mangiacotti/N1/N1 rev0.ods

Sheet: ToC
ID Range | Title | Status | Name | Date
100 | Terms and Acronyms | released | mangiacotti | 13-Jun-2016
200 | Use Cases | released | mangiacotti | 13-Jun-2016
300 | Requirements | released | mangiacotti | 13-Jun-2016
400 | Specifications | released | mangiacotti | 13-Jun-2016
500 | Functions | released | mangiacotti | 13-Jun-2016
600 | Spec Tests | completed | mangiacotti | 14-Jun-2016
700 | System Tests | completed | mangiacotti | 13-Jun-2016
800 | Exception Tests | completed | mangiacotti | 13-Jun-2016
900 | BOM | released | mangiacotti | 26-May-2016
1000 | Schematics | released | mangiacotti | 14-Jun-2016
1100 | Defects | mediums and highs closed | mangiacotti | 4-Jun-2016
1200 | Signature Manifest | released | mangiacotti | 12-Jun-2016
n/a | User Manual | not started
n/a | Rev History | pending tests for release | mangiacotti | 13-Jun-2016

Sheet: Terms and Acronyms
100
ID | Term or Acronym | Description
101 | SBC | Single Board Computer
102 | LED | Light Emitting Diode
103 | NVM | Non-Volative Memory
104 | checksum | MD-5 hashing algorithm of the code for comparisions
105 | LTQ | Long Term Qualification. Post release
106 | STQ | Short Term Qualification. Prior to release
107 | PCB | Printed Circuit Board

Sheet: Defects
1100
ID | Defect Description | Criticality | Resolution | Status | Version Fixed In | Name | Date Closed
1101 | LEDs cycle when setting is required but how to handle when red has been set but not yellow | medium | new requirements to separate blinking instead of cycling | closed | 1.0 | mangiacotti | 31-May-2016
1102 | Create a 'processMessage' function so that messages can be suppressed when not in verbose mode | medium | canceled. Better performance as-is and still readable | closed | 1.0 | mangiacotti | 31-May-2016
1103 | How annunciate to user of invalid distance setting | high | Keep blinking light until set correctly | closed | 1.0 | mangiacotti | 31-May-2016
1104 | More code comments | high | done | closed | 1.0 | mangiacotti | 02-Jun-2016
1105 | With a human body in front of ultra-sonic sensor, there are some spurious readings of objects being far away. Experiment with function 'sonar.ping_median' | medium | ping_median is very slow scanning. Makes push buttons inconsistent. Plan to test with automobiles. | closed |  | mangiacotti | 09-Jun-2016
1106 | Push buttons not consistent because they are pushed for more than one scan | high | program a button_unclick event | closed | 1.0 | mangiacotti | 12-Jun-2016
1107 | Save settings to EEPROM | high | EEPROM.get() and EEPROM.put() included value validation | closed | 1.0 | mangiacotti | 12-Jun-2016
1108 | Power-up product information report to serial port | high | added function. Included control code 501 support. Included checksum of source code | closed | 1.0 | mangiacotti | 12-Jun-2016
1109 | Proper name | low | Parky McParkFace? | open |  | mangiacotti
1110 | Lenses for amplifying small LED to be visible from far away | low |  | open
1111 | Proper box to place components into | low |  | open
1112 | If red distance is set to less than yellow distance then yellow distance is essentially disabled | low |  | open

Sheet: Use Cases
200
ID | Description | Notes
201 | Set yellow light distance
202 | Set red light distance
203 | Clear all settings
204 | Yellow light on 30 seconds when within yellow range
205 | Red light on 30 seconds when within red range
206 | Green light on for 30 seconds when not within yellow or red range
207 | Power-on light sequence to inform user that distance setting is required
208 | Save all settings to NVM

Sheet: Requirements
300
ID | Description | Notes
301 | User shall be able to press a momentary push-button to set the distance to energize the yellow light
302 | System shall report status to user of success/failure of setting yellow light distance
303 | System shall report status of setting yellow light distance to serial port of SBC
304 | User shall be able to press a momentary push-button to set the distance to energize the red light
305 | System shall report status to user of success/failure of setting red light distance
306 | System shall report status of setting red light distance to serial port of SBC
307 | User shall be able to clear all settings
308 | System shall monitor distance of objects from it's on-board sensor
309 | Yellow light shall stay on continuously when within range
310 | Red light shall stay on continuously when within range
311 | Yellow light shall go off immediately when within red light range | red light range in [309]
312 | Green light shall go on continuously when outside of red light range and yellow range | red light range in [309], yellow [308]
313 | System shall save yellow and red light distance settings to NVM
314 | System shall report to user that yellow and red distance settings required
315 | System shall have a debug mode for testing and diagnostics
316 | System shall be able to energize and de-energize red LED for diagnostics
317 | System shall be able to energize and de-energize yellow LED for diagnostics
318 | System shall be able to energize and de-energize yellow LED for diagnostics
319 | System shall be able to display product information

Sheet: Specifications
400
ID | Description | Notes | Req ID
401 | User presses button next to yellow LED, system shall take 10 sample of the distance detected by the ultra sonic sensor and will take an average of the 10 samples. The average will be the yellow light distance | set yellow light distance | 301
402 | System will report success of yellow light distance setting by turning the yellow LED steady on for 10 seconds (distance average is less than 10 feet) |  | 302
403 | System will report failure of yellow light distance setting by blinking the yellow LED for 1/4 on and 1/4 off for 10 seconds (distance average greater than 10 feet) |  | 302
404 | System will report on the SBC serial port the response time of each of the ultra sonic sensor samples taken for yellow light distance setting |  | 303
405 | System will report on the SBC serial port the calculated distance of each of the ultra sonic sensor samples taken for yellow light distance setting |  | 303
406 | System will report on the SBC serial port the average distance calculated of the samples taken for yellow light distance setting |  | 303
407 | System will report success of yellow light distance setting to the SBC serial port when distance is less than 10 feet for yellow light distance setting |  | 303
408 | User presses button next to red LED, system shall take 10 sample of the distance detected by the ultra sonic sensor and will take an average of the 10 samples. The average will be the red light distance | set red light distance | 304
409 | System will report success of red light distance setting by turning the red LED steady on for 10 seconds (distance average is less than 10 feet) |  | 305
410 | System will report failure of red light distance setting by blinking the red LED for 1/4 on and 1/4 off for 10 seconds (distance average greater than 10 feet) |  | 305
411 | System will report on the SBC serial port the response time of each of the ultra sonic sensor samples taken for red light distance setting |  | 306
412 | System will report on the SBC serial port the calculated distance of each of the ultra sonic sensor samples taken for red light distance setting |  | 306
413 | System will report on the SBC serial port the average distance calculated of the samples taken for red light distance setting |  | 306
414 | System will report success of red light distance setting to the SBC serial port when distance is less than 10 feet for red light distance setting |  | 306
415 | User presses both the red and yellow distant set buttons and the stored distances will be cleared |  | 307
416 | System shall report success of settings clearing by blinking the red and yellow LED for 1/4 on and 1/4 off for 10 seconds |  | 307
417 | System shall report on the SBC serial port the success of clearing yellow and red distance settings |  | 307
418 | An ultra sonic sensor shall be used to measure distance of objects from the sensor |  | 308
419 | The system shall calculate distance (in inches and centimeters) from the sensor to objects in its path. Calculation will be based on distance measured in [417] |  | 308
420 | System shall detect serial port message to the SBC of "101" and report distance in inches and centimeters to the SBC serial port upon each successful read and calculate | start_diag = 101 | 308, 315
421 | System shall detect serial port message to the SBC of "102" and stop reporting distance in inches and centimeters to the SBC serial port upon each successful read and calculate | stop_diag = 102 | 308, 315
422 | When distance calculated in [419] is less than or equal to yellow light setting in [401] then system shall turn on the yellow LED for 30 seconds |  | 309
423 | When distance calculated in [419] is less than or equal to yellow light setting in [401] then system shall report on the serial port of the SBC that the yellow distance has been encroached |  | 309
424 | When distance calculated in [419] is less than or equal to red light setting in [408] then system shall turn on the red LED for 30 seconds |  | 310
425 | When distance calculated in [419] is less than or equal to red light setting in [408] then system shall report on the serial port of the SBC that the red distance has been encroached |  | 310
426 | When the system has detected an object is within red light setting [424], the yellow LED will be turned off |  | 311
427 | When distance calculated in [419] is greater than yellow light setting in [401] and red light setting in [408] then the green LED will be turned on for 30 seconds |  | 312
428 | When distance calculated in [419] is greater than yellow light setting in [401] and red light setting in [408] then the system shall report on the serial port of the SBC that the green LED is activated |  | 312
429 | System shall save red and yellow distance settings to NVM storage on SBC whenever they change |  | 313
430 | System shall report on the SBC serial port the success of saving settings |  | 313
431 | System shall blink the red LED continuously when red distance setting is required |  | 314
432 | System shall blink the yellow LED continuously when yellow distance setting is required |  | 314
433 | System shall detect serial port message to the SBC of "201" to energize the red LED | control code 201 | 316
434 | System shall detect serial port message to the SBC of "202" to de-energize the red LED | control code 202 | 316
435 | System shall detect serial port message to the SBC of "301" to energize the yellow LED | control code 301 | 317
436 | System shall detect serial port message to the SBC of "302" to de-energize the yellow LED | control code 302 | 317
437 | System shall detect serial port message to the SBC of "401" to energize the green LED | control code 401 | 318
438 | System shall detect serial port message to the SBC of "402" to de-energize the green LED | control code 402 | 318
439 | System shall report product information to the SBC serial port upon SBC power-on |  | 319
440 | System shall detect serial port message to the SBC of "501" to report product information to the SBC serial port | control code 501 | 319

Sheet: Functions
500 |  | Paramter 1 | Paramter 2 | Paramter 3
ID | Type and Function Name | Type and Name | Type and Name | Type and Name
501 | void setup
502 | void loop
503 | void sonarPing
504 | void checkForObjects
505 | void blinkRedLED | int iNumScansToIllum
506 | void blinkYellowLED | int iNumScansToIllum
507 | void processSerialMessage
508 | void reportProductInfo
509 | void writeSettingsToNVM
510 | void readSettingsFromNVM

Sheet: Spec Tests
600
ID | Description | Recorded Results | Version tested | Initials | Date
601 | Yellow light distance set and report confirmation
 | Specification ID [401, 402, 403, 404, 405, 406, 407]
 | 1. Remove power from system
 | 2. Wait 10 seconds
 | 3. re-apply power and wait for red, yellow and green lights to blink on/off
 | 4. Connect Serial Port terminal software to system
 | 5. Place automobile or other large object in front of ultra sonic sensor
 | 6. Press button next to yellow LED
 | 7. Ensure Yellow LED is steady off and serial port report of successful distance setting | as expected | 1.0 | SAM | 13-Jun-2016
 | 8. Ensure Red LED remains off | as expected | 1.0 | SAM | 13-Jun-2016
602 | Red light distance set and report confirmation
 | Specification ID [408, 409, 410, 411, 412, 413, 414]
 | 1. Ensure Spec Test [601] above has completed successfully | as expected | 1.0 | SAM | 13-Jun-2016
 | 3. re-apply power and wait for red, yellow and green lights to blink on/off
 | 4. Connect Serial Port terminal software to system
 | 5. Place automobile or other large object in front of ultra sonic sensor
 | 6. Press button next to yellow LED
 | 7. Ensure Red LED is steady off and serial port report of successful distance setting | as expected | 1.0 | SAM | 13-Jun-2016
 | 8. Ensure Yellow LED remains off | as expected | 1.0 | SAM | 13-Jun-2016
603 | Clear all settings confirmation
 | [415, 416, 417]
 | 1. Ensure Spec Test [601] above has completed successfully | as expected | 1.0 | SAM | 13-Jun-2016
 | 2. Ensure Spec Test [602] above has completed successfully | as expected | 1.0 | SAM | 13-Jun-2016
 | 3. Press and hold both buttons next to red and yellow LED simultaneously
 | 4. Ensure red, yellow and green LED blink approx 1/4 second on and 1/4 second off | as expected | 1.0 | SAM | 13-Jun-2016
 | 5. Ensure successful status of clearing settings is reported on the serial port monitor | as expected | 1.0 | SAM | 13-Jun-2016
604 | Ultra Sonic Sensor test
 | [418, 419]
 | 1. Connect Serial Port terminal software to system
 | 2. Enter diagnostics mode by typing '101'
 | 3. Locate an automobile or other large device approx. 1 meter (3 feet) from ultra sonic sensor
 | 4. Monitor serial port messages from sensor and ensure distance values are approx 1 meter (+/- 10 cm) | as expected | 1.0 | SAM | 14-Jun-2016
 | 5. Locate an automobile or other large device approx. 2 meter (6 feet) from ultra sonic sensor
 | 6. Monitor serial port messages from sensor and ensure distance values are approx 2 meter (+/- 10 cm) | as expected | 1.0 | SAM | 14-Jun-2016
 | 7. Exit diagnostics mode by typing '102'
605 | Start/stop diagnostics messaging mode to serial port test
 | [420, 421]
 | 1. Connect Serial Port terminal software to system
 | 2. Enter diagnostics mode by typing '101'
 | 3. Ensure diagnostics mode is active by detecting distance and ping time values on the SBC serial port | as expected | 1.0 | SAM | 13-Jun-2016
 | 4. Exit diagnostics mode by typing '102'
606 | Object within yellow light distance range test
 | [422, 423]
 | 1. Ensure Spec Test [601] above has completed successfully
 | 2. Ensure Spec Test [602] above has completed successfully
 | 3. Connect Serial Port terminal software to system
 | 4. Remove automobile or large object being used for testing from the test area completely
 | 5. Return automobile or large object to the test area near the system slowly until yellow LED is lit
 | 6. Ensure Yellow LED is lit, red LED is not lit and green LED is not lit | as expected | 1.0 | SAM | 13-Jun-2016
 | 7. Ensure serial port messages indicate the yellow light is activated | as expected | 1.0 | SAM | 13-Jun-2016
607 | Object within red light distance range test
 | [424, 425, 426]
 | 1. Ensure Spec Test [601] above has completed successfully
 | 2. Ensure Spec Test [602] above has completed successfully
 | 3. Connect Serial Port terminal software to system
 | 4. Remove automobile or large object being used for testing from the test area completely
 | 5. Return automobile or large object to the test area near the system slowly until red LED is lit
 | 6. Ensure red LED is lit, yellow LED is not lit and green LED is not lit | as expected | 1.0 | SAM | 13-Jun-2016
 | 7. Ensure serial port messages indicate the red light is activated | as expected | 1.0 | SAM | 13-Jun-2016
608 | Green light activate test
 | [427, 428]
 | 1. Ensure Spec Test [601] above has completed successfully
 | 2. Ensure Spec Test [602] above has completed successfully
 | 3. Connect Serial Port terminal software to system
 | 4. Remove automobile or large object being used for testing from the test area completely
 | 5. Ensure red LED is not lit and yellow LED is not lit and green LED is lit for approx 30 seconds | as expected | 1.0 | SAM | 13-Jun-2016
 | 6. Ensure serial port messages indicate the green LED is activated | as expected | 1.0 | SAM | 13-Jun-2016
609 | Save settings to NVM test
 | [429, 430]
 | 1. Connect Serial Port terminal software to system
 | 2. Ensure Spec Test [601] above has completed successfully
 | 3. Ensure Spec Test [602] above has completed successfully
 | 4. Ensure serial port monitor displays successful save of settings | as expected | 1.0 | SAM | 13-Jun-2016
610 | Distance setting needed test
 | [431, 432]
 | 1. Remove power from system
 | 2. Wait 10 seconds
 | 3. Re-apply power to system
 | 4. Ensure red blinks approx. 1/4 on and 1/4 off continuously | as expected | 1.0 | SAM | 13-Jun-2016
 | 5. Ensure yellow blinks approx. 1/4 on and 1/4 off continuously | as expected | 1.0 | SAM | 13-Jun-2016
 | 6. Ensure green light is off | as expected | 1.0 | SAM | 13-Jun-2016
 | 7. Perform Spec Test [601] successfully
 | 8. Ensure red light is off | as expected | 1.0 | SAM | 13-Jun-2016
 | 9. Perform Spec Test [602] successfully
 | 10. Remove any object from the ultra sonic sensor path
 | 11. Ensure yellow light is off | as expected | 1.0 | SAM | 13-Jun-2016
611 | Energize, de-energize red, yellow and green LED via serial port terminal
 | [433, 434, 435, 436, 437, 438]
 | Testing these requirements and specifications not necessary.
 | These are diagnostics operations only and not used in normal user operations
612 | Report product information to serial port
 | [439, 440]
 | 1. Ensure serial port monitoring is enabled
 | 2. Remove power from system
 | 3. Wait 10 seconds
 | 4. Re-apply power to system
 | 5. Ensure product version information is displayed on serial port monitor (minimum req. is product name and version) | as expected | 1.0 | SAM | 13-Jun-2016
 | 6. Enter value "501" in the serial port monitor
 | 7. Ensure product version information is displayed on serial port monitor (minimum req. is product name and version) | as expected | 1.0 | SAM | 13-Jun-2016

Sheet: System Tests
700
ID | Description | Notes | Recorded Results | Version tested | Initials | Date
701 | Below 75% program storage space used | Record actuals from IDE message window | 25% | 1.0 | SAM | 13-Jun-2016
702 | Record bytes used/maximum of program storage space |  | 8340 bytes | 1.0 | SAM | 13-Jun-2016
703 | Below 75% dynamic memory for global variables used | Record actuals from IDE message window | 51% | 1.0 | SAM | 13-Jun-2016
704 | Record bytes used/maximum of dynamic memory for global variables |  | 1048 bytes | 1.0 | SAM | 13-Jun-2016
705 | Record the source file size in kb (*.ino) |  | 12288 bytes | 1.0 | SAM | 13-Jun-2016
706 | Record the date/time stamp of the source file (*.ino) |  | 13Jun 2016, 08:17 | 1.0 | SAM | 13-Jun-2016
707 | Record the MD-5 hash in the product information report from serial port |  | ab88-50e7-4ede-7883-bba3-6083-d66b-52de | 1.0 | SAM | 13-Jun-2016
708 | 9V alkaline battery life of no less than six months - short term | Test based on internet research | failed | 1.0 | SAM | 14-Jun-2016
709 | 9V alkaline battery life of no less than six months - long term | Live test | canceled due to ID [708] failure | 1.0 | SAM | 15-Jun-2016
710 | Heat load of board and circuitry inside enclosure not to exceed 85 Deg C | Limit based on Arduino specs | postponed. Will be treated as a LTQ test | 1.0 | SAM | 15-Jun-2016

Sheet: Exception Tests
800
ID | Description | Notes | Spec ID
801 | All identified Exception Tests are included in Spec Tests

Sheet: BOM
900
ID | Description | Part Number | Quantity | Notes
901 | Arduino Uno | n/a | 1 | Considering change to Pro Mini or MKR model family
902 | Enclosure | n/a | 1
903 | Momentary push button | n/a | 2
904 | Red LED | n/a | 1
905 | Yellow LED | n/a | 1
906 | Green LED | n/a | 1
907 | 10K Ohm resistor | n/a | 2
908 | 220 Ohm resistor | n/a | 3
909 | 9V battery adapter | n/a | 1
910 | Toggle switch (on/off) | n/a | 1
911 | Lenses to amplify LED illumination |  | 3
912 | 5-12Vdc power adapter |  | 1

Sheet: Schematics
1000
ID | Description | Notes
1001 | see file 'N1 electrical schematics rev0.odg'
1002 | see file 'N1 pcb layout rev0.fxx' | zero boards fabricated to date

Sheet: User Manual
include general specs
temp
power

Sheet: Rev History
Revision | Name | Date | Notes and Description | MD-5 Hash Checksum Value
0.9 | Mangiacotti | 13-Jun-2016 | First draft of all tabs except Build Instructions and User Manual See defects tab for details. | bb1f-3229-614f-dfe3-5610-c2dc-103d-9553
1.0 | Mangiacotti | 25-Jun-2016 | Releasing version 1.0 with the following known issues: | cef2-2a2b-7360-8519-d7f7-3c71-040e-cc6e
 |  |  | Low priority defects unresolved ID [1109, 1110, 1111, 1112] See 'Defects' tab for details
 |  |  | System Test ID [708, 709] failed due to battery life limits below spec See 'System Tests' tab for details
 |  |  | System Test ID [710] postponed to be included as LTQ activity. See 'System Tests' tab for details
 |  |  | Bill of Material ID [911, 912] part numbers undefined. See 'BOM' tab for details
 |  |  | User manual incomplete
 |  |  | Reference schematic version 'N1 electrical schematics rev0.odg'
 |  |  | Reference PCB layout version 'N1 pcb layout rev0.fzz'
 |  |  | Note: MD-5 hash checksum value generated by setting checksum value in code to empty quotes (“”), selecting all text and using a hash generator

Sheet: Signature Manifest
1200
ID | Initials | Given Name | Family Name | Date Recorded | Credentials
1201 | SAM | Scott | Mangiacotti | 12-Jun-2016 | designer, programmer, tester
