mangiacotti/N1/(list of files, drawings)

Other design files:
N1 pcb layout rev0.fzz
